ricardofalcao/FEUP-SBMI-Trabalho/README.md

# Line-Following-Robot
Made in the Microcontrollers-based systems course in FEUP.
Featuring an OLed peripheral, RF communication and PID controller.
