ricardofalcao/FEUP-SBMI-Trabalho/report/imagens/sensors.png

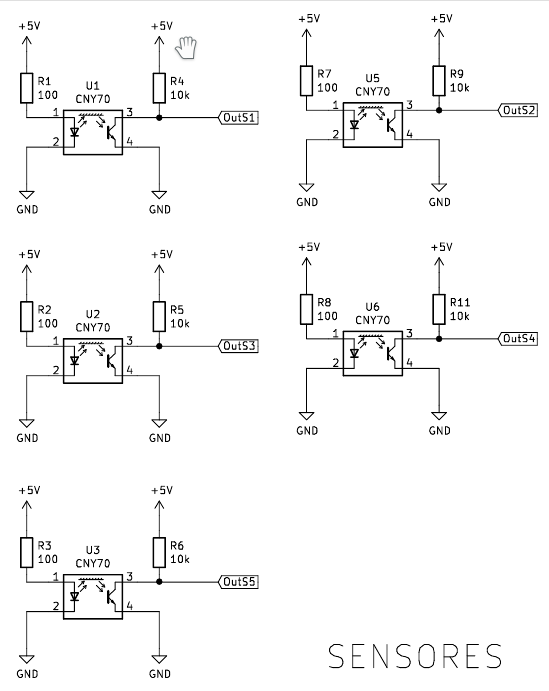
report/imagens/sensors.png
