ricardofalcao/FEUP-SBMI-Trabalho/schematics/sbmi/sbmi.kicad_pcb

## KiCad design de_jesus_sergio/de_jesus_sergio.sch


Parts:
C1: 100n
D1: LED ROJO
D2: 1N4148
K1: CONN_3
R1: 100K

Connections:
unnamed: C1.1, D1.1 (K), R1.1
unnamed: C1.2, D1.2 (A), K1.1
unnamed: D2.1 (K), K1.3
unnamed: D2.2 (A), R1.2
