ricardofalcao/FEUP-SBMI-Trabalho/(commit log)

2019-12-02 Adicionado API de IR
2019-12-04 Organizado projeto e melhorias no sistema de IR
2019-12-04 Adicionado logica de posiçao, erro, PID e multi-caminhos
2019-12-22 Adicionado sistema de sensores
2019-12-31 Iniciado relatorio
    [sbmi.kicad_pcb, sbmi.sch]
